htynkn/agentdock/hardware/README.md

# AgentDock Hardware

Mechanical files for the AgentDock desktop controller: the reference **PCB 3D
model** (exported from EasyEDA Pro), a parametric **two-piece printed enclosure**
(base + lid) built with [build123d](https://build123d.readthedocs.io/), and the
**acrylic front panel** outline that drops into the lid (order from JLC panel).
Everything prints on an FDM printer without supports.

```
hardware/
├── pcb/                     PCB 3D model (EasyEDA Pro STEP export)
│   └── PCB.step
├── enclosure/               Parametric enclosure project
│   ├── pcb_model.py         STEP parser: extracts board outline, holes,
│   │                        component envelopes; validates against design
│   │                        anchors (EXPECT table) and fails loudly on a
│   │                        PCB revision that breaks the enclosure
│   ├── enclosure.py         Main model: base + lid + panel, exports STEP/STL
│   │                        + panel DXF, runs dimensional + interference
│   │                        + tolerance-budget self-checks
│   ├── render.py            matplotlib preview renders (6 views)
│   ├── panel_drawing.py     dimensioned drawing of the acrylic panel (ordering)
│   ├── panel_print.py       panel print artwork (front + mirrored back PDF/SVG)
│   │                        with an automatic ink-clearance check
│   ├── PANEL.md             panel ordering guide (JLC panel): file, parameters,
│   │                        dimensions, red lines, silkscreen notes
│   ├── thickness_check.py   STL wall-thickness probe (ray casting) — reproduces
│   │                        the online "thin wall" warning and locates it
│   ├── output/              Generated: STEP/STL/DXF + pcb_report.json (git-ignored)
│   ├── render/              Generated: PNG previews (git-ignored)
│   └── pyproject.toml       uv project (Python 3.12, build123d 0.13)
└── .github/workflows/       CI: builds model headless, uploads STL/STEP/DXF + previews
```

## Enclosure design

Two printed parts + one glued panel, **no supports needed**:

* **Base** — floor + walls, 4 × Ø8 screw bosses (the two right-hand ones get a
  gusset to the +X wall; the two left-hand ones stand clear of the left wall,
  which sits `LEFT_EXTRA` = 1.0 mm further out), 4 longitudinal + 1 transverse
  rib supporting the PCB from below, wall openings (USB-C, toggle switch, buzzer
  ports, ESP32 antenna vents). The PCB sits in a cavity with **1.0 mm clearance
  per side** (2.0 mm on the left), so it can be nudged until the four holes line
  up before driving the screws.
* **Lid** — 2.0 mm top plate carried by a 1.8 mm raised rim (which is also the
  acrylic panel seat), 3.0 mm locating lip (notched at the four posts), 4 posts
  with glued knurled nuts (**Ø3.8 bore from the post foot → cavity ceiling**, so
  the Ø3.5 nut can actually be pushed in), 3 key windows (19 × 19), Ø13.6 knob
  recess + Ø8.6 shaft hole, WS2812 light port as a **stepped** counterbore
  (Ø8 → Ø5.2 → Ø3.4), and four stiffening ribs under the plate.
* **Panel** — 1.5 mm printed acrylic/PC + 0.16 mm adhesive tape (Crown #513), glued
  into the rim 0.14 mm below the rim top; its
  cut-outs (3 key windows, knob, light port) are derived from the same
  parameters, so `output/Panel.dxf` is always in sync with the printed lid.

### Changes from the first printed revision

The first physical build surfaced three problems; each fix is asserted by the
build itself:

| Problem | Root cause | Fix |
|---|---|---|
| Screw holes did not line up — only half of each PCB hole visible | The PCB had ±0.5 mm of play in the cavity, but the Ø2.7 pass-hole around a Ø2.5 screw only allows ±0.1, and FDM shrink over the 86 mm hole pattern is ≈0.34 mm | Cavity clearance 0.5 → **1.0 mm**; pass-hole Ø2.7 → **Ø3.4** (±0.45); head counterbore Ø4.8 → **Ø6.0** (±0.70) + 45° lead-in cone; bosses Ø6 → **Ø8** to keep 1.0 mm of wall around the bigger counterbore |
| Lid felt floppy | Three 19 × 19 key windows split the plate into 1.64 mm strips that were only 1.6 mm thick | Plate 1.6 → **2.0 mm**; 4 mm deep ribs under the two inter-window strips (and one across the free band above them); lip 1.5 → **3.0 mm**; 1.7 mm raised rim around the top edge |
| No place for the acrylic panel | — | Rim around the top face: the panel drops inside it and ends up 0.14 mm **below** the rim top, so the rim guards the printed face |

Bending stiffness of the inter-window strips (the part that made the lid feel
soft): 1.64 × 2.0 mm flat strip ≈ 1.1 mm⁴ → T-section (1.64 × 2.0 plate + a
1.0 × 4.0 rib) ≈ 25.7 mm⁴, i.e. **≈ 23× stiffer** in the same load direction,
before the thicker plate and the perimeter rim are counted.

### Changes from the second printed revision

The second physical build fit the screws only with the PCB pushed hard against
the left (-X) wall, and that in turn threw the toggle-switch window off. Both
symptoms came from the same cause: the base ribs were pressing on bottom-side
solder joints, so the board could not sit where the openings expect it.

| Problem | Root cause | Fix |
|---|---|---|
| Screws align only with the PCB jammed to the far left; switch window then wrong | Rib #1 (X 7.0–8.9) was 1.2 mm from SW1's left pin — but the STEP only contains the Ø0.6 pin (reaching z = −1.914 below the board), while the real solder fillet is 0.5–0.8 mm fatter, so it lifted the board and the board could only sit jammed left | Rib #1 moved to X **5.4–7.4** (2.7 mm from the pin); pass-hole Ø3.4 → **Ø3.8** (±0.65) |
| Switch knob hits the window when thrown to one side | The window was centred on the lever's *as-exported* position (X 18.16), but the lever sits at the end of its travel (electrical centre 16.51 + half of the 3.3 mm travel) → whole window 1.65 mm too far right | Window centred on the switch's **electrical centre** (middle signal pin) and sized from both travel extremes (`sw_slot_x()`, 8.0 mm wide, symmetric) |
| PCB would not seat around EC11 (same soldered-joint risk) | The corridor between key 3 (bottom geometry ends at 69.23) and the EC11 bracket leg (starts at 73.09) is only 3.86 mm wide while the PCB still has ±1.0 mm of play, so the 1.2 mm rib left only 0.3–0.4 mm at the extreme; the corner rib ran to y = 23.5 beside the three signal pins (y ≥ 24.1); the Ø7 encoder post was close to both | Rib #4 **removed** (the transverse rib already crosses that band), corner rib ends at y = **22.6**, encoder post Ø7 → **Ø5.0** (3.2 mm to the nearest bracket leg) |
| Left wall crowded the screw holes | The two left Ø8 bosses merge into the left wall, so the Ø6 counterbore cuts into it and only 0.36 mm of wall is left beside the bore | Left wall moved out by `LEFT_EXTRA` = **1.0 mm** (outer width 97.175 → 98.175); bosses, ribs, wall openings and panel cut-outs keep their positions. The USB-C receptacle ends up **1.0 mm recessed** relative to the outer face — accepted |

`SOLDER_CLEAR = 1.0 mm` now encodes this rule: every base rib and the encoder
support post is inflated by that much in XY and must miss all below-board PCB
geometry. It is asserted at build time, so the next PCB revision cannot silently
reintroduce a solder-joint collision.

### Fastener tolerance budget (the "holes don't line up" fix)

When the screw is driven in from below, its lateral position is pinned by the
tightest link in the chain: the PCB hole (Ø2.7 around a Ø2.5 screw = ±0.10), so
the screw follows the board. Everything else has to absorb the rest:

| Feature | Diameter | Slack per side | Absorbs |
|---|---|---|---|
| Base pass-hole | Ø3.8 | ±0.65 | PCB position in the cavity + print shrink |
| Head counterbore | Ø6.0 | ±0.70 | screw head offset |
| Lid nut cavity | Ø3.8 | ±0.65 | screw entering the glued nut |

Print shrink over the 86 mm hole pattern at 0.4 % is ≈0.34 mm (≈0.17 per side).
`enclosure.py` prints this table and fails if any slack drops below 0.35 mm.

Two failure modes are asserted by the build itself instead of being discovered
on the printing platform:

| Check | Limit | Why |
|---|---|---|
| Wall thickness (ray casting, `thickness_check.py`) | no surface thinner than 0.5 mm | shallow cones and half-millimetre rings get flagged as "thin wall" |
| Nut pass-through | a Ø3.4 probe swept from each post foot to the cavity floor must leave 0 mm³ | the Ø3.5 knurled nut has to physically enter the post; a Ø2.7 sleeve in the way is invisible to the "is the hole open?" check |
| Topology | no edge < 0.02 mm, no face < 1e-4 mm², single valid solid | resin/SLA services reject such geometry as "bad edges" |
| Rib clearance | every lid rib ≥ 0.15 mm from a key window / knob hole / light port | a rib under a key window blocks the keycap |
| Solder clearance (base) | every base rib and the encoder support post, inflated by `SOLDER_CLEAR` = 1.0 mm, must leave 0 mm³ against all below-board PCB geometry | the ribs touch the PCB, so a solder fillet on a Ø0.6 pin (the STEP knows nothing about solder) lifts the board and shifts every PCB-derived opening |
| Switch travel window | the knob envelope at both travel extremes must leave 0 mm³ | a window centred on the exported lever position leaves the knob hitting one end, which reads as "the opening is wrong" |

Key dimensions (derived from the PCB STEP at load time — not hard-coded):

| Item | Value |
|---|---|
| Outer size | 98.175 × 48.175 × 22.30 mm (base 18.50 + lid plate 2.0 + rim 1.8); the left wall sits `LEFT_EXTRA` = 1.0 mm further out than the rest of the layout, so the outer width is 98.175 instead of 97.175 |
| Cavity | 94.975 × 44.975 mm, R3.987; PCB clearance 2.0 mm on the left (-X), 1.0 mm elsewhere |
| PCB | 91.975 × 42.975 × 1.586 mm, corners R2.987 |
| PCB standing height | bottom face at z = 5.0 (3.4 mm above the floor; lowest solder tips still clear the floor by 1.49 mm) |
| PCB support | 4 corner bosses + 4 longitudinal + 1 transverse rib, tops all at z = 5.0 |
| Mounting holes | 4 × Ø2.7, PCB local (1.65, 3.0) / (87.65, 3.0) / (1.65, 40.0) / (87.65, 40.0) |
| Key windows | 3 × 19 × 19 mm centered on the key stems |
| Encoder | PCB local (79.375, 31.746) — the 2026-10-27 PCB moved it 1.53 mm left of the previous (80.90, 31.75); all lid features follow the STEP, nothing is hard-coded |
| Encoder hole | Ø8.6 through + Ø13.6 × 0.8 knob skirt recess, concentric with the EC11 bushing (0.00 mm offset; Ø8.6 leaves 0.8 mm around the Ø7 bushing so hole shrink from printing cannot jam it) |
| Lid stiffening | 2.0 mm plate + 2 ribs (1.0 × 4.0) under the inter-window strips + 1 rib (1.2 × 4.0) across the free band at PCB-local y = 24.5 + 3.0 mm lip + 2.6 × 1.8 mm rim |
| Min wall thickness | 0.86 mm (Base) / 0.80 mm (Lid), zero area below 0.5 mm |
| USB-C panel opening | 9.60 × 3.86 mm, **centered on the plug cavity** |
| PCB hole pattern | 86.0 × 37.0 mm, symmetric about (44.65, 21.50) while the board is centered at (46.00, 21.50) → the pattern sits 1.35 mm left of the board centre |

### Acrylic front panel (JLC panel)

`uv run enclosure.py` also emits **`output/Panel.dxf`** (mm, layer `PANEL`) —
upload it as the panel outline + cut-outs and pick:

| Item | Value |
|---|---|
| Material | acrylic / PC, **1.5 mm** thick, printed on the back (1.0 mm also works: set `PANEL_T = 1.0`, `RIM_H` auto-drops to 1.20) |
| Outline | **92.67 × 42.67 mm**, corners R2.84 |
| Cut-outs | 3 × key window **19.2 × 19.2** R2.1, knob **Ø13.8**, light port **Ø3.6** |
| Attachment | 0.16 mm Crown **#513** white-translucent PET double-sided tape on the back (long-term 80 °C, `PANEL_TAPE`), glued into the rim |

The panel sits **inside** the 2.6 mm wide rim and ends up 0.14 mm below the rim
top (`RIM_H` = panel stack rounded up to whole 0.2 mm layers); the rim
locates it (0.15 mm per side), hides its edges and protects it from knocks. All
cut-outs derive from the enclosure parameters, and the build asserts every panel
opening is ≥ the corresponding lid opening, so the panel can never cover a
window. The lid's knob pocket (Ø13.6 × 0.8) and the light port stay visible
through the panel holes.

`uv run panel_drawing.py` renders `render/panel_drawing.png`, a dimensioned
drawing (measured from the panel's own lower-left corner) for checking the order
before submitting it. The full ordering guide — what to upload, which JLC
parameters to pick, the dimension table and the three things that must not
change — lives in **[enclosure/PANEL.md](enclosure/PANEL.md)**.

#### Panel print artwork ("orrery" theme)

`uv run panel_print.py` draws the print layer as a 1:1 vector file: near-black
flood + emerald green + matte gold linework, one single wordmark
(`AgentDock`), **no text on the keys** — each key window gets three concentric
ring arcs instead — a 24-tick astrolabe ring around the knob, and a `STATUS`
ring around the light port. `Panel_print_front.pdf` is what a viewer sees;
`Panel_print_back.pdf` is the same artwork mirrored for printing on the **back**
of the acrylic (the durable option: ink sealed inside the 1.5 mm sheet).
Stroke widths are 0.16–0.30 mm, and `panel_print.py` asserts every stroke keeps
≥ 0.40 mm from the five cut-outs and from the panel outline, failing the build
otherwise.

The light port leaves an **unprinted** annulus (r 1.8–3.35) instead of ink: the
1.5 mm acrylic plus the white-translucent Crown #513 tape diffuses the WS2812,
so the ring around the port glows when the LED is on. Printing white or black
over that annulus would block it.

### Fasteners (hidden, screws from the bottom)

| Part | Spec | Qty |
|---|---|---|
| Pan-head screw | **M2.5 × 8** (head Ø4.6 × 1.9) | 4 |
| Knurled brass nut | **M2.5, L4.0, Ø3.5 OD** (LCSC C51938993 or equivalent) | 4 |
| Adhesive | AB (two-part epoxy) | — |
| Panel tape | Crown #513 white-translucent PET, 0.16 mm | — |

```
z = 0      base floor (screw head sunk: Ø6.0 × 2.2 counterbore)
           z = 2.2 → 3.5 45° lead-in cone Ø6.0 → Ø3.8
z = 5.0    boss tops / PCB bottom face
z = 6.586  PCB top face
z = 6.786  all four lid post feet — identical posts, length 11.71 mm
           (PCB top + 0.2 mm contact sweep; the 2026-10-27 PCB moved the
           encoder 1.53 mm left, so its metal bracket no longer sits under the
           right-top mounting hole)
z = 6.79–10.99  nut cavity Ø3.8 × 4.2, mouth at the post foot; the nut is
           pushed in only 0.2 mm until it seats against the cavity ceiling,
           i.e. it lives at z = 6.99–10.99, flush with the post foot
```

* The bore from every post foot up to the cavity ceiling is **Ø3.8, not
  Ø2.7**. An earlier revision left a Ø2.7 "screw guide" sleeve between the post
  foot and the cavity mouth; the Ø3.5 nut cannot pass it, so the posts could
  never be fitted with a nut (the screws just spun). The build now asserts nut
  pass-through (see the self-checks) and the four posts look identical from
  below: Ø4.4 mouth step + Ø3.8 bore.

* The Ø3.8 cavity leaves 0.15 mm per side around the Ø3.5 knurled nut for the
  epoxy layer; the knurl bites into the cured adhesive.
* The cavity mouth uses a **Ø4.4 × 0.8 step** (not a 45° × 0.5 chamfer): a
  chamfer leaves only 0.42 mm of sloped wall between the cone and the Ø6 post
  surface, which is thin enough to be rejected; the step leaves 0.80 mm and its
  ledge doubles as the glue reservoir. The step sits at the **post foot** on all
  four posts, i.e. right at the cavity mouth. It must be ≥ 0.5 mm deep,
  otherwise the Ø4.4↔Ø3.8 ring land itself is a 0.4 mm thin wall.
* The lid posts stay **Ø6** even though the base bosses grew to Ø8: a Ø8 lid
  post makes the foot probe (Ø8/2 + 0.3) touch the encoder's metal bracket
  (top at z = 6.09), which would lift the right-top post to z = 11.29 and drag
  all four nut cavities up with it — the M2.5 × 8 screw would then never reach
  the nut. The Ø6 post keeps all four feet on the PCB top face.
* The Ø6.0 head counterbore leaves 1.0 mm to the Ø8 boss OD, and the head has
  ±0.70 mm of lateral slack — this is what lets a slightly misaligned PCB still
  be screwed down.
* M2.5 × 8 engages ~3.2 mm (≈ 7 threads); the tip (z = 10.20) stays inside the
  through-hole nut (z = 6.99–10.99) and never bottoms out — the build asserts
  engagement ≥ 2.0 mm and a ≥ 0.5 mm gap under the tip. With the nut cavity at
  the post foot (see below), **M2.5 × 12 / × 10 overshoot the cavity ceiling**
  (tips at z = 14.20 / 12.20, ceiling at 10.99) — use **× 8**.
* Note: all four posts are now the same length and all four rest on the PCB top
  face. Up to the 2026-10-25 PCB revision the encoder sat over the right-top
  mounting hole, its metal bracket forced that post to stop at z = 11.29 (7.2 mm
  long) and all four nut cavities had to be raised to match, which is why the
  older builds needed M2.5 × 12. The 2026-10-27 PCB moved the encoder 1.53 mm
  left; the bracket is clear of the hole (its top is at z = 6.09, i.e. 0.70 mm
  below the new post feet), so that exception is gone.

### Wall openings

| Opening | Wall | Size |
|---|---|---|
| USB-C receptacle | −X | **9.60 × 3.86** — the real plug is 8.25 × 2.4 and the receptacle cavity is 8.40 × 2.66, so the opening is the cavity + 0.6 per side (0.68 mm clearance per side for the plug shell) and is centered on the **cavity axis**, not on the connector body bbox: the bbox includes the locating legs that reach down to z = 0.586, which puts its centre 0.48 mm below the plug axis |
| Toggle switch lever | +Y | **9.0 × 3.8** — sized for the SK-12E12 lever's full ±25° horizontal swing (verified by a 2 763-point sweep simulation, 0 contacts) |
| Buzzer sound ports | +X | 4 vertical slots facing the buzzer |
| ESP32 module vents | +Y | 4 slots behind the module antenna area |

## Usage

```bash
cd hardware/enclosure
uv sync                     # Python 3.12 + build123d 0.13
uv run pcb_model.py         # parse the PCB STEP, validate against anchors
uv run enclosure.py         # model + export STEP/STL + self-checks
uv run thickness_check.py output/Lid.stl --min 0.5   # locate thin walls
uv run thickness_check.py output/Base.stl --min 0.5 --top 8
uv run render.py            # PNG previews into render/
uv run panel_drawing.py     # dimensioned panel drawing for the JLC order
uv run panel_print.py       # print artwork: Panel_print_{front,back}.pdf/.svg
```

Generated files: `Base.step/.stl`, `Lid.step/.stl`, `Panel.stl`,
**`Panel.dxf`** (order the acrylic panel from this),
**`Panel_print_front.pdf/.svg` + `Panel_print_back.pdf/.svg`** (print artwork;
the back file is pre-mirrored for reverse printing), `pcb_report.json`.

`uv run enclosure.py` prints a self-check report and exits non-zero on any
failure: outer dimensions, panel dimensions, single-solid check, exact boolean
interference (`PCB ∩ Base`, `PCB ∩ Lid`, `Lid ∩ Panel` must all be < 0.01 mm³),
screw passage (the Ø6.0 counterbore, the 45° cone and the Ø3.8 pass-hole must be
empty — the right-hand bosses carry a gusset across the screw area, so the holes
are cut **after** the gussets), **nut pass-through** (a Ø3.4 × full-travel probe
swept from each post foot to the cavity floor must be empty — this is what
catches a post that is too narrow for the nut), screw engagement (≥ 2.0 mm, tip
must not bottom out), the **fastener tolerance budget** (every slack ≥ 0.35 mm),
**rib clearance** (every lid rib ≥ 0.15 mm from a key window / hole), **solder
clearance** (every base rib and the encoder support post, inflated by
`SOLDER_CLEAR`, must miss all below-board PCB geometry), the **toggle-switch
travel window** (the knob envelope at both travel extremes), the Type-C plug
path, wall thickness and topology.

### After a PCB revision

**Currently pinned: 2026-10-31 export** (`hardware/pcb/PCB.step`, SHA-256
`32271557391e1d…`). It differs from the 2026-10-27 revision by exactly one
solid: a 3.2 × 1.6 × 1.3 mm SMD at X 21.73–23.33 moved 0.635 mm down in Y
(31.03–34.23 → 30.40–33.60). No anchor in `EXPECT` moved, `PCB ∩ Base` and
`PCB ∩ Lid` are still 0.0000 mm³, and the regenerated Base/Lid/Panel STLs are
byte-identical — the enclosure needs no change.

1. Re-export the STEP from EasyEDA Pro and save it as `hardware/pcb/PCB.step`
   (dated exports may live alongside; only `PCB.step` is tracked).
2. Update the SHA-256 pin in `.github/workflows/hardware.yml`.
3. Update the `EXPECT` table in `pcb_model.py` if any anchor moved
   (board outline, holes, key/encoder positions, connector envelopes,
   **USB plug cavity**). `pcb_model.py` fails with a diff of what changed —
   update the enclosure parameters accordingly before rebuilding.

Note: `PCB.step` is ~17 MB; it is tracked because the enclosure geometry is
verified against it in CI. Dated exports (`3D_PCB1_<date>.step`) are
git-ignored.

## Printing

* Material: PLA or PETG for FDM; the STEP is also clean enough for resin/SLA
  (no degenerate edges, valid BRep — see the topology check)
* 0.2 mm layers, 3 walls, 20 % infill, **no supports**
* Base prints floor-down. The Ø6.0 counterbores sit on the bed, so the 45°
  lead-in cones print as normal cones; the two left-hand counterbores cut 0.36 mm
  into the inside of the side wall (the wall keeps 1.24 mm above them).
* Lid prints **rim-down**: the 2.6 mm wide rim frame is the only bed contact,
  the 2.0 mm plate is a flat bridge, and the lip, posts and stiffening ribs all
  grow upward — no overhangs, no supports. Wall thickness check reports 0.80 mm
  minimum.

## Assembly

1. Glue the 4 knurled nuts into the lid posts: butter the nut with AB epoxy,
   push it in **from the post foot** until it bottoms out against the cavity
   ceiling — only 0.2 mm of travel now, i.e. the nut ends up flush with the post
   foot. Threading the nut onto a spare M2.5 screw or a Ø2.5 rod makes a handy
   insertion tool — hold ~30 s until the epoxy grabs.
2. Drop the PCB into the base. The cavity is deliberately larger than the board
   (1.0 mm per side, 2.0 mm at the USB-C end); the ribs no longer press on any
   bottom-side solder joint, so the board sits flat. Nudge it until all four
   Ø2.7 holes show as full circles through the Ø3.8 pass-holes — they are
   visible through the counterbores from below — then check the USB-C
   receptacle and the toggle lever in their wall openings.
3. Place the lid; the lip locates in the cavity, posts rest on the PCB.
4. Drive 4 × M2.5 × 8 pan-head screws **from the bottom** — heads sink into the
   Ø6.0 counterbores and the lead-in cone pulls the screw towards the pass-hole
   centre, which also drags the PCB into place. Tighten evenly (the board is
   clamped between the boss tops and the post feet, so it no longer moves).
5. Peel the tape and press the acrylic panel into the rim; it drops into the
   frame and sits 0.14 mm below the rim top. Feed the knob through the
   Ø13.8 panel hole onto the EC11 shaft last.

## CI

`.github/workflows/hardware.yml` runs the parametric build headless on every
push/PR touching `hardware/**`, runs the full self-check suite, renders the
preview images and the assembly animation, and uploads a
`agentdock-hardware-<run>` artifact containing the printable STL/STEP files, the
panel DXF, the panel print PDF/SVG (front + mirrored back), the preview PNGs and
`assembly.mp4` / `assembly.gif`.
