htynkn/agentdock/hardware/pcb/PCB.step

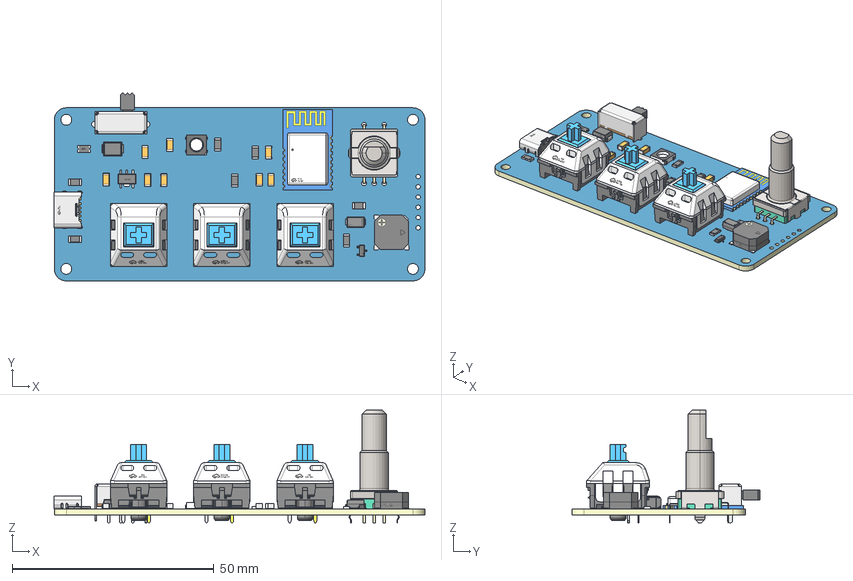
[picture p1: CAD file, 2026-11-02]
hardware/pcb/PCB.step
92.0 x 46.6 x 28.0 mm
Board~cvpW
TopCopper~cvpW
BottomCopper~cvpW
TopSilkscreen~cvpW
BottomSilkscreen~cvpW
TopFpcStiffener~cvpW
BottomFpcStiffener~cvpW
C1206~C1206_L3.2-W1.6-H1.3~BW2Y x 8
TYPE-C-SMD_TYPE-C-6P_1~TYPE-C-SMD_6P-L8.9-W6.8-H3.2-P1.00~CjXS
R1206~R1206_L3.2-W1.6-H0.6~Vecb x 7
SOT-23-3_L2.9-W1.3-P1.90-LS2.4-BR~SOT-23-3P_L2.9-W1.3-H1.0-LS2.4-P0.95~IlkC
SW-TH_SK-12E12-G5~SW-TH_SK-12E12-G5~M2Xo
F1206~F1206_L3.2-W1.7-H0.6~DiZD
SOT-89-5_L4.5-W2.5-P1.50-LS4.5-BR~SOT-89-5_L4.5-W2.5-H1.5-LS4.1-P1.50~n7M4
SMB_L4.6-W3.5-LS5.3-BI~SMB_L4.6-W3.5-LS5.3-BI~jcIo
BUZ-SMD_4P-L8.5-W8.5-BR-1~BUZ-SMD_4P-L8.5-W8.5-H4.0~2Y4y
KEY-TH_CPG151101D21X~KEY-TH_L15.6-W14.0-H15.3~Ye3T x 3
SMA_L4.3-W2.6-LS5.0-RD~SMA_L4.3-W2.6-LS5.0-RD~KIqM
LED-SMD_4P-L5.0-W5.0-TL-A~LED-SMD_4P-L5.0-W5.0-H1.57-TL_WS2812B-B~13Xh
SW-TH_EC11NXXXX~SW-TH_EC11NXXXX-L11.7-W12.0-H24.5-P2.5-LS14.5~XNsp
WIFIM-SMD_ESPC2-M1~WIFIM-SMD_ESPC2-M1~NUt6
