htynkn/agentdock/(commit log)

2026-10-25 feature: init AgentDock firmware and pi extension (#1)
    * chore: publish AgentDock firmware and pi extension
    - ESP-IDF firmware for ESP32-C2 (keys, encoder, WS2812, buzzer, BLE GATT)
    - pi coding agent TypeScript extension (BLE bridge, /dock panel, scrolling)
    - English README, MIT license and .gitignore for ESP-IDF/Node projects
    - GitHub Actions CI: firmware build and plugin typecheck for PRs and master
    * ci: fix plugin install and always upload firmware artifacts
    - align npm with the npm 11 generated lockfile
    - skip optional native BLE dependencies during typecheck install
    - add a fallback install path for npm registry hiccups
    - upload the ESP32-C2 firmware on every run, including pull req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
    [app_events.h, config.c, config.h, deck.c, deck.h, fx.c, fx.h]
2026-10-25 Add parametric AgentDock enclosure with CI and assembly animation (#6)
    * feature: parametric AgentDock enclosure (build123d) with CI build
    hardware/ tree:
    - pcb_model.py: parses the EasyEDA PCB STEP and validates design anchors
    (board outline, mounting holes, key stems, encoder, connectors) against
    an EXPECT table so a PCB revision fails loudly instead of silently
    breaking the enclosure
    - enclosure.py: parametric base + lid, exports STEP/STL and runs
    dimensional + exact boolean interference self-checks (PCB n Base =
    PCB n Lid = 0)
    - render.py: matplotlib preview renders (assembled/exploded/top views)
    Design notes:
    - outer 96.175 x 47.175 x 20.1 mm; PCB stands 3.4 mm above the flo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
    [PCB.step]
2026-10-26 fix(enclosure): make nut cavity reachable from every lid post (#10)
2026-10-27 feat(enclosure): rebuild for the 2026-10-27 PCB revision (#12)
    [PCB.step]
2026-10-30 Publish pi-plugin to npm with release automation and documentation (#13)
    * feat(pi-plugin): make the package publishable to npm
    - drop private, add the pi manifest (pi.extensions), files whitelist and
    publishConfig.access so `npm publish` ships only the extension sources
    - move @earendil-works/pi-coding-agent and pi-tui to peerDependencies with
    a "*" range: pi provides them, installed copies create duplicate modules
    - add keywords "pi-package" for gallery discovery, repository.directory for
    the monorepo link, license/LICENSE (MIT) and a prepublishOnly gate that
    runs typecheck + tests
    - document npm publishing, version/tag flow and CI trusted publishing in
    PUBLISHING.md; README now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
2026-10-31 Fix screw hole alignment, stiffen lid, and add panel drawing (#14)
    * feat(enclosure): fix screw hole alignment, stiffen the lid, add panel seat
    First physical build surfaced three problems; all three are now asserted by
    the parametric build instead of being found on the print bed.
    1. Screw holes did not line up (only half of each PCB hole visible)
    The screw's lateral position is pinned by the tightest link in the chain —
    the PCB hole (Ø2.7 around a Ø2.5 screw = ±0.10) — so the base features have
    to absorb the rest. They could not: pass-hole Ø2.7 (±0.10), head counterbore
    Ø4.8 around a Ø4.6 head (±0.10), and the board had ±0.5 of undefined play in
    the cavity on top of ≈0.34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
2026-11-02 chore(hardware): 换用 2026-10-31 版 PCB STEP（外壳无需改动） (#15)
    * chore(hardware): 换用 2026-10-31 版 PCB STEP
    新导出（EasyEDA Pro，2026-10-31 20:17）与仓库内的 2026-10-27 版逐个比对
    全部 67 个实体，差异仅一处：一颗 3.2 × 1.6 × 1.3 的贴片
    (X 21.73–23.33, 体积 6.39 mm³) 沿 Y 下移 0.635（31.03–34.23 → 30.40–33.60）。
    外壳不受影响：
    - pcb_model.EXPECT 全部锚点（板框/板厚/圆角/4 孔/3 键/编码器/USB 座与插头空腔/
    拨动开关/蜂鸣器/WS2812/板底最低点）零差异，容差 0.02 mm
    - PCB ∩ Base = 0.0000 mm³，PCB ∩ Lid = 0.0000 mm³
    - 重建后的 Base/Lid/Panel STL、Panel.dxf、以及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
    [PCB.step]
2026-11-09 fix(enclosure): second-prototype fixes — solder clearance, switch window, panel width (#17)
    * chore: remove promo directory
    * fix(enclosure): clear bottom-side solder joints and re-centre switch window
    Second physical build fit the screws only with the PCB jammed to the far
    left, which then pushed the toggle-switch window out of alignment. Both
    symptoms traced to the base ribs pressing on bottom-side solder joints
    (the STEP only carries the Ø0.6 pins, the real fillets are 0.5-0.8 fatter),
    so the board could never sit where the openings expect it.
    - ribs: #1 7.0-8.9 -> 5.4-7.4 (2.7 mm from SW1's left pin), #4 70.5-72.5
    -> 70.6-71.8 (1.4/1.3 mm from the EC11 bracket leg), corner rib en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
2026-11-11 fix(pi-plugin): make BLE connection actually work — worker subprocess + auto-rebind (#19)
    Debugging "device discovered but never connects" on a live AgentDock revealed
    three stacked problems:
    1. noble connectAsync resolves undefined on success; the new timeout guard
    treated that as a timeout and cancelled the just-established connection.
    The NimBLE firmware stops advertising while connected, so the fallback
    rescan always timed out -> permanent reconnect loop. Normalize success
    with .then(() => true).
    2. The bound device name no longer matched the hardware (names embed the
    MAC suffix; the board was swapped). connect() returned not_found and the
    single-device case retried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
2026-11-12 feat(firmware): 旋钮刻度音, 顺/逆时针音高走向不同 (#20)
    EC11 转动时给出齿轮感反馈: 每格一次 11ms 的双段滑音,
    顺时针 2200→3000Hz (上滑) / 逆时针 2200→1500Hz (下滑)
    共同起音 + 相反走向, 快转时方向差异也能听出来.
    实现要点:
    - fx 层新增 fx_encoder_click(dir) 与独立刻度音队列, 不走 RTTTL
    (旋律最短音符 20ms 以上, 刻度音需要 ~10ms 级延迟)
    - 同格 4 个正交跳变靠 CLICK_GAP_MS(22ms) 合并成一次发声, 换向立即放行
    - fx 任务空转轮询从 100ms 缩到 10ms, 刻度音延迟 ≤10ms; 队列仅 4 深
    且满即丢, 快转时牺牲完整性保实时性
    - 静音沿用 KEY1 长按开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
2026-11-12 feat: 设备设置面板 + 演示模式 + 刻度音开关 (含 /dock 死锁修复) (#21)
    * feat: 刻度音开关 + KEY2 演示模式 + 亮度/音量设置
    四项设备体验调整 (固件 + pi 扩展):
    1. 长按 KEY3 开关旋钮刻度音
    与 KEY1 静音并列, 独立持久化到 NVS (key: click), 默认开。
    关掉后不再往刻度音队列投递, 静音仍为总开关。开关时播一短一长/一长一短确认音。
    2. 长按 KEY2 进入演示模式
    播放魂斗罗丛林关 riff (22 个 16 分音符) + LED 七彩呼吸 3s 后回到 agent 真实
    状态。纯设备本地动作, 未连接 pi 也能演示。
    为此把 LED 状态机从 fx 任务拆到独立 led_task (互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
    [app_events.h, config.c, config.h, deck.c, fx.c, fx.h, input.c, main.c]
2026-11-12 chore(pi-plugin): release v0.3.0
    - CHANGELOG 把 Unreleased 拆成两个版本段: 0.2.0 (2026-11-11, BLE worker 子进程化
    与连接稳定性修复, 当时漏记录) 与 0.3.0 (本次设备设置/演示模式/刻度音开关
    + /dock 死锁修复)
    - package.json 0.1.0 → 0.3.0 (发布工作流仍会按 tag 覆写版本号)
    - README 里锁版本的示例同步到 0.3.0
    自检: tsc 通过, vitest 77 passed, check:pack tarball ok (9 files, 23 KB)
